ZigEmbeddedGroup/sycl-badge/carts/15/assets/joshwolfe.png

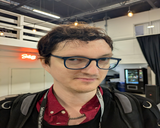
carts/15/assets/joshwolfe.png
