ZigEmbeddedGroup/sycl-badge/carts/zeroman/assets/needleman.png

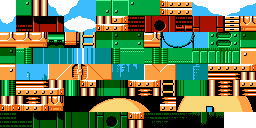
carts/zeroman/assets/needleman.png
