ZigEmbeddedGroup/sycl-badge/src/charset.png

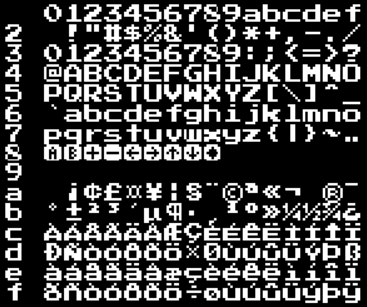
src/charset.png
