ZigEmbeddedGroup/sycl-badge/src/simulator/assets/npx_bloom_small.png

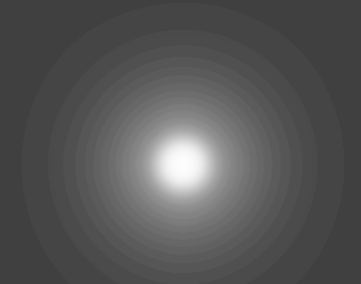
src/simulator/assets/npx_bloom_small.png
