ZigEmbeddedGroup/sycl-badge/src/simulator/assets/sim_bg.jpg

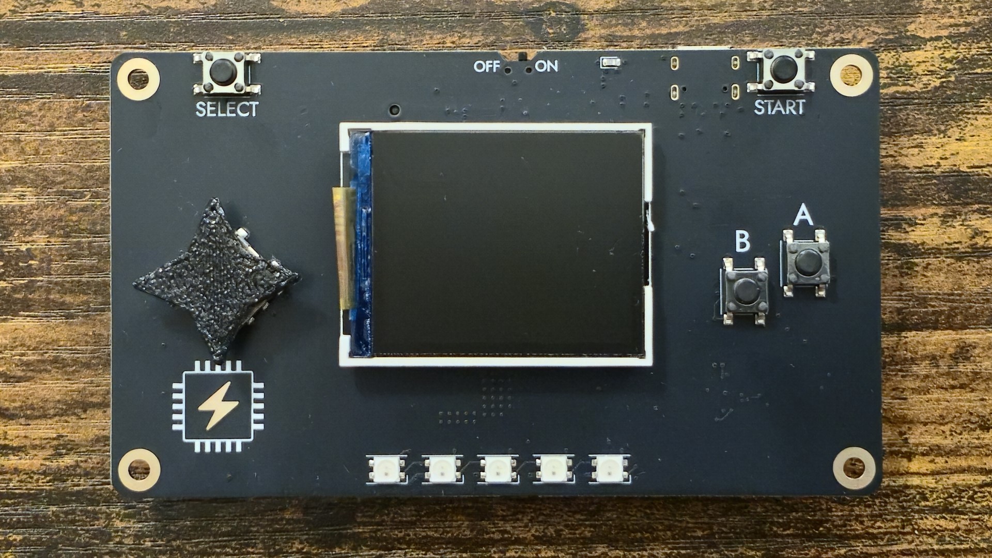
src/simulator/assets/sim_bg.jpg
