ZigEmbeddedGroup/sycl-badge/attachments/dpad_v1.3mf

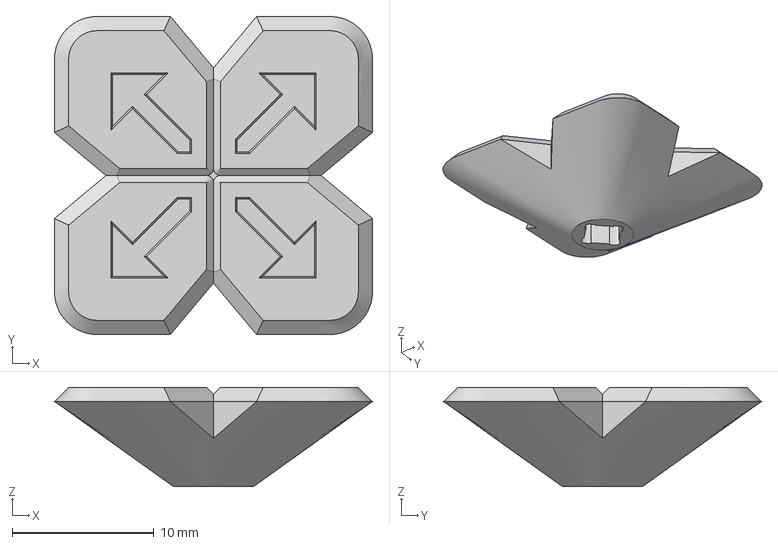
[picture p6: CAD file, 2026-08-16]
attachments/dpad_v1.3mf
22.4 x 22.4 x 7.00 mm
