ZigEmbeddedGroup/sycl-badge/kicad/v2/CMT_7525_80_SMT_TR/CMT-7525-80-SMT-TR.step

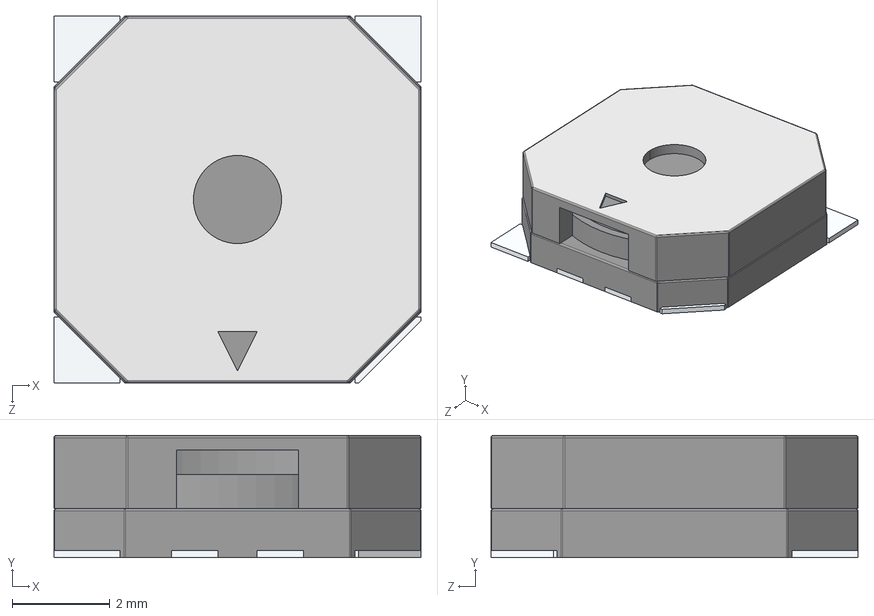
[picture p7: CAD file, 2026-04-12]
kicad/v2/CMT_7525_80_SMT_TR/CMT-7525-80-SMT-TR.step
7.50 x 2.50 x 7.50 mm
