ZigEmbeddedGroup/sycl-badge/kicad/v2/TPS61041DBVR/TPS61041DBVR.step

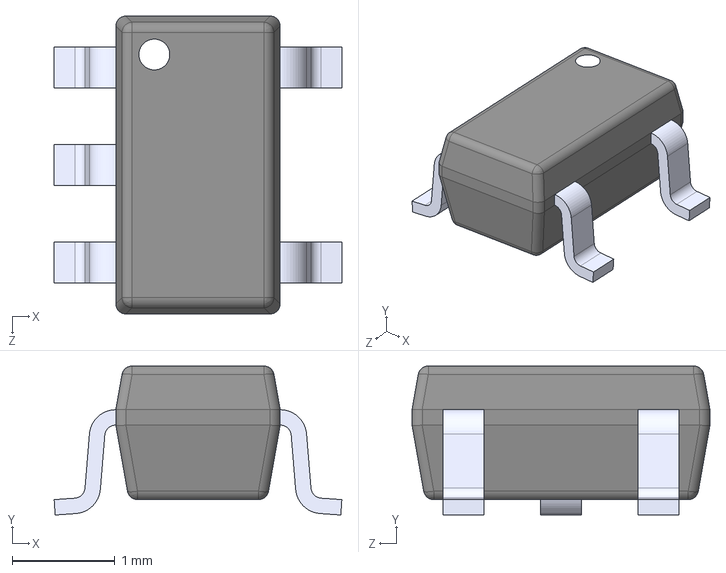
[picture p8: CAD file, 2026-04-12]
kicad/v2/TPS61041DBVR/TPS61041DBVR.step
2.80 x 1.45 x 2.90 mm
