ZigEmbeddedGroup/sycl-badge/(threads)

Thread 19 (2024-04-11):

Simulator / API Tasklist

SuperAuguste, 2024-04-11:
- [ ] `wasm4.print` that uses `std.fmt`
- [ ] custom panic handler to show panic causes to user
- [ ] Make reloader stable
- [ ] Fix `wasm4.blit`
- [ ] Explore making more `wasm4.zig` functions use structs for readability

JerwuQu, 2024-04-11:
I'll throw in a few small tasks too

- [ ] control list on game page
- [ ] SVG console border
- [ ] replace `[Z]` & `[X]` with `[A]` & `[B]` in embedded font (also for firmware)

Thread 104 (2025-10-02):

Basic File System Implementation and Storage Layer

katie-goncalves, 2025-10-02:
⦁	Look into implementing read/write to memory
⦁	File creation/deletion (subtask of the above task)
⦁	Directory structure (if needed, or flat structure) or indexing system for multiple cart storage

Thread 99 (2025-10-02):

Kernel Core

katie-goncalves, 2025-10-02:
⦁	Implement task scheduler - task switching
⦁	Implement multitasking (context switching, threads/tasks)
⦁	Memory management (stack allocation, heap basics if needed)
