ZigEmbeddedGroup/sycl-badge/(commit log)

2023-10-27 Initial vomit: Code compiles, datasheets, pinout, schematic
2023-10-28 Adds debug scripts for openocd/gdb (bad state)
    [gdb.cfg]
2023-11-24 Implement first pass display driver (#5)
2023-11-26 Implement first pass audio driver (#6)
2024-01-14 Board design Rev1 (#8)
    * rev1 of board
    * moved files
    * vendor 3d models
    [SYCL Badge 2024.kicad_pcb, SYCL Badge 2024.kicad_sch]
2024-01-15 connect B7 and A6 of USB connector (#9)
    [SYCL Badge 2024.kicad_pcb, SYCL Badge 2024.kicad_sch]
2024-01-21 implement suggestions by jacobly (#10)
    * implement suggestions by jacobly
    * remove submodule
    * make sure all tracks and vias are consistent
    [SYCL Badge 2024.kicad_pcb, SYCL Badge 2024.kicad_sch]
2024-01-22 rev1 of board (#11)
    [SYCL Badge 2024.kicad_pcb, SYCL Badge 2024.kicad_sch]
2024-01-25 rev2 of board (#12)
    * rev2 of board
    * final touches
    [SYCL Badge 2024.kicad_pcb, SYCL Badge 2024.kicad_sch]
2024-03-22 Board rev3 (#15)
    * add test points
    * switch pins on JST connector
    * rotate JST connector
    * TVS diode and testpoints
    * Revision 3 of the board
    [SYCL Badge 2024.kicad_pcb, SYCL Badge 2024.kicad_sch]
2024-04-03 Board rev A (#16)
    * drop test points, add jlcpcb production files
    [SYCL Badge 2024.kicad_pcb, SYCL Badge 2024.kicad_sch]
2024-04-23 Build watcher on macOS (#26)
    Link missing frameworks CoreFoundation and CoreServices
2024-05-14 Neopixels and light sensor work for the badge (#38)
2024-05-15 Improve accuracy of charging instructions
2024-05-15 LCD Communication fix (#48)
    * update microzig, include lcd
    * wip
    * wip
    * SPI communication with LCD is fixed
    * increase cart ram allocation
    * add framebuffer to cart fixed memory
2024-05-15 bump SPI frequency to 12MHz (#54)
2024-05-15 Implement draw functions (#53)
    * baddrawimpls
    * More drawfuncs
    * fix opt mode
    * Blit done too
    * Modify intro docs, add back feature test leds
2024-05-17 Add metal gear timer showcase (#60)
    * Add metal gear timer showcase
    * Add metalgear-timer to build.zig and build.zig.zon
2024-05-17 Merge DMA code into main (#62)
    * lcd dma
    * Implement missing functions for neopixels demo
    ---------
2024-05-18 Revert "Merge DMA code into main (#62)"
    This reverts commit 5340483f74af477412901b74645f4b9437119e59.
    This PR was not up to date.
2024-05-18 Add DVD sample (#66)
2024-05-18 Implement lcd dma (#67)
2024-05-19 Fix framebuffer writes; remove extra write (#68)
2024-05-19 Fix intro, remove samples dir (#70)
2025-08-14 Fix Missing USB Traces (#74)
    This fixes a massive issue I created for myself last year. I made the
    assumption that the matching D+/- pins on the USB-C connecter were
    electrically tied in the connector, and therefore I did not have to tie
    them together myself. This was incorrect and resulted in having to
    insert two small jumpers in every one of the 125 production boards which
    was pure pain.
    [SYCL Badge 2024.kicad_pcb]
2025-08-30 Reorganize kicad directory to allow for more boards (#76)
    [SYCL Badge 2024.kicad_pcb, SYCL Badge 2024.kicad_sch]
2025-10-16 made folder for v2 badge
    cloned files to new v2 badge folder
    [SYCL Badge 2024.kicad_pcb, SYCL Badge 2024.kicad_sch]
2025-10-16 added rp2354b symbol library
    added rp2354b symbol library + added to schematic
2025-10-17 Voltage regulator circuit
    added the voltage regulator circuit
    [HTMLparser.obj, HTMLtree.obj, SAX.obj, SAX2.obj, SYCL Badge 2024.kicad_sch, buf.obj, build_zcu.obj, c14n.obj]
2025-10-17 voltage regulator circuit
    [SYCL Badge 2024.kicad_sch]
2025-10-20 updated v2 mcu pinout
    - updated v2 mcu pinout to make connections easier
    - added decoupling capacitor circuit
    [SYCL Badge 2024.kicad_sch]
2025-10-22 added lcd conn
    [SYCL Badge 2024.kicad_sch]
2025-10-23 reverted schematic file (#110)
    reverted schematic file to git
    [SYCL Badge 2024.kicad_sch]
2025-10-24 updated MCU connections
    added various component connections to MCU
    [SYCL Badge 2024.kicad_sch]
2025-10-25 finished lcd connections
    completed lcd connection to mcu and added led driver lib
    [SYCL Badge 2024.kicad_sch]
2025-10-29 added power circuitry
    [SYCL Badge 2024.kicad_sch]
2025-10-30 fixed num of IRQ interrupt handlers 48 -> 52
2025-10-31 Updated kernel with blinking LED
2025-10-31 added usb-c
    [SYCL Badge 2024.kicad_sch]
2025-10-31 Updated build.zig to build linker kernel and boot
    *This is a working buildable code which turns the LED on*
    Build.zig: Added OS building functionality
    linker.ld: Updated to handle bootloader metadata properly
    boot.S: Added bootloader metadata section
2025-11-02 started routing pcb
    finished updating schematic and started routing v2 pcb
    [SYCL Badge 2024.kicad_pcb, SYCL Badge 2024.kicad_sch]
2025-11-05 continued routing PCB
    continued routing PCB including internal voltage regulator and USB-C portion
    [SYCL Badge 2024.kicad_pcb, SYCL Badge 2024.kicad_sch]
2025-11-05 routing pcb pt.3
    finished routing decoupling capacitors + power circuit with the switch
    [SYCL Badge 2024.kicad_pcb]
2025-11-05 Temporary build.zig with no custom linker or boot for LED blink
2025-11-06 deleted extra circuits
    deleted extra circuits - old usb-c and old mcu
    [SYCL Badge 2024.kicad_sch]
2025-11-07 continued routing PCB
    continued routing PCB - battery pack, buttons, LCD
    [SYCL Badge 2024.kicad_pcb, SYCL Badge 2024.kicad_sch]
2025-11-07 gpio and uart wrapper imports from microzig. kernel cleaned up and refactored, and rewritten in zig
2025-11-07 Updated usb driver code
2025-11-08 continued routing PCB
    continued routing PCB - USB-C, tag connect
    [SYCL Badge 2024.kicad_pcb, SYCL Badge 2024.kicad_sch]
2025-11-09 started some pours
    started doing some pours and changing width of traces
    [SYCL Badge 2024.kicad_pcb]
2025-11-10 continued drawing pours
    continued drawing pours for voltage input
    [SYCL Badge 2024.kicad_pcb]
2025-11-10 finished routing
    finished first revision routing
    [SYCL Badge 2024.kicad_pcb]
2025-11-11 DRC clean-up
    [SYCL Badge 2024.kicad_pcb]
2025-11-11 DCR complete, added testpoints on schematic
    [SYCL Badge 2024.kicad_pcb, SYCL Badge 2024.kicad_sch]
2025-11-12 testpoints added
    [SYCL Badge 2024.kicad_pcb, SYCL Badge 2024.kicad_sch]
2025-11-13 finished routing
    completed routing on pcb - ready to order first revision of v2
    [SYCL Badge 2024.kicad_pcb]
2025-11-13 exported gerber files
    exported gerber files, have to edit the bom
    [SYCL Badge 2024-B_Cu.gbl, SYCL Badge 2024-B_Mask.gbs, SYCL Badge 2024-B_Paste.gbp, SYCL Badge 2024-B_Silkscreen.gbo, SYCL Badge 2024-Edge_Cuts.gm1, SYCL Badge 2024-F_Cu.gtl, SYCL Badge 2024-F_Mask.gts, SYCL Badge 2024-F_Paste.gtp]
2025-11-13 updated uart
2025-11-13 timer changes
2025-11-13 Fixed uart.zig filed
2025-11-13 Updated timer.zig
2025-11-14 commpleted interrupt driver
2025-11-14 Increased print buffer length
2025-11-14 exported gerber files
    exported gerber files and found out ic package is wrong :(
    [SYCL Badge 2024-B_Cu.gbl, SYCL Badge 2024-B_Mask.gbs, SYCL Badge 2024-B_Paste.gbp, SYCL Badge 2024-B_Silkscreen.gbo, SYCL Badge 2024-Edge_Cuts.gm1, SYCL Badge 2024-F_Cu.gtl, SYCL Badge 2024-F_Mask.gts, SYCL Badge 2024-F_Paste.gtp]
2025-11-14 wip driveer code for lcd - untested since we have no board yet
2025-11-14 updated mcu with correct package
    updated mcu with correct packaging and finished routing and drcs
    [SYCL Badge 2024.kicad_pcb]
2025-11-15 finished updating pcb
    ready to order ! maybe..
    [SYCL Badge 2024-B_Cu.gbl, SYCL Badge 2024-B_Mask.gbs, SYCL Badge 2024-B_Paste.gbp, SYCL Badge 2024-B_Silkscreen.gbo, SYCL Badge 2024-Edge_Cuts.gm1, SYCL Badge 2024-F_Cu.gtl, SYCL Badge 2024-F_Mask.gts, SYCL Badge 2024-F_Paste.gtp]
2025-11-18 Updated documentation to have printf examples
2025-11-18 fixed references
    [SYCL Badge 2024.kicad_sch]
2025-11-22 interrupt tests
2025-11-24 Moved interrupt test to tests folder
2025-11-24 Setup init.zig for abstracted initialization and began pin assignment for lcd
2026-01-07 changes from milestone 2 doc
    [SYCL Badge 2024.kicad_pcb, SYCL Badge 2024.kicad_sch]
2026-01-07 LCD initial integration for RP Pico 2
2026-01-07 testpoints changed
    [SYCL Badge 2024.kicad_pcb, SYCL Badge 2024.kicad_sch]
2026-01-07 changed panic so it now loops for 50 while fast flashing led and attemps reboot. if it fails then stuck in while true
2026-01-08 added footprints
    added footprints for lcd connector and smd battery pack
    [SYCL Badge 2024.kicad_pcb, SYCL Badge 2024.kicad_sch]
2026-01-13 new lcd connector
    [SYCL Badge 2024.kicad_pcb, SYCL Badge 2024.kicad_sch]
2026-01-14 lcd connector
    [SYCL Badge 2024.kicad_pcb]
2026-01-14 started to change usb-c footprint
    [SYCL Badge 2024.kicad_sch]
2026-01-14 new usb-c connector
    [SYCL Badge 2024.kicad_pcb, SYCL Badge 2024.kicad_sch]
2026-01-15 finished updating usb-c connector
    [CMT-7525-80-SMT-TR.step, SYCL Badge 2024.kicad_pcb, SYCL Badge 2024.kicad_sch]
2026-01-16 finished all updates to v2 rev2
    finished drc and all updates to v2 rev2
    [SYCL Badge 2024.kicad_pcb, SYCL Badge 2024.kicad_sch]
2026-01-20 updated battery pack footprint
    [SYCL Badge 2024.kicad_pcb, SYCL Badge 2024.kicad_sch]
2026-01-20 updated lcsc part numbers
    [SYCL Badge 2024.kicad_sch]
2026-01-21 updated components with JLCPCB p/ns and downloaded Gerber files
    [SYCL Badge 2024.kicad_pcb, SYCL Badge 2024.kicad_sch]
2026-01-21 Centralized pin assignments to board_v2.zig
2026-01-28 print files on lcd
2026-02-04 Cleaned up dated comments and those intended for Pico 2 but not sycl badge
2026-02-05 Neopixel leds setup including test cart
2026-02-06 Added joystick and buttons GPIO pins
2026-02-06 Fixed led pin definition in console
2026-02-06 Fixed BL driver pin
2026-02-09 Fixed gpio bugs and setup buttons correctly
2026-02-09 Fixed panic lcd pin and added milestone 3 demo cart
2026-02-10 added u9 and fixed mcu connections
    [SYCL Badge 2024.kicad_sch, TPS61041DBVR.step]
2026-02-10 Removed all the UART code
2026-02-10 Double uart commit for no reason?
2026-02-11 added boost circuitry and changed QSPI cs
    [SYCL Badge 2024.kicad_sch]
2026-02-11 button (gpio 10)
2026-02-11 button change
2026-02-11 buttons work, just needed resistor
2026-02-12 finished schematics
    [SYCL Badge 2024.kicad_sch]
2026-02-12 stop button, added and working. cart start button doesn't work properly.. invert colors
2026-02-12 added inductor footprint
    [SYCL Badge 2024.kicad_sch]
2026-02-12 d8_ resistor added
    [SYCL Badge 2024.kicad_sch]
2026-02-12 Minor LCD fixes but still needs lots of work (DMA)
2026-02-12 updating PCB routing, LCD complete
    [SYCL Badge 2024.kicad_pcb, SYCL Badge 2024.kicad_sch]
2026-02-12 updated pcb
    [SYCL Badge 2024.kicad_pcb, SYCL Badge 2024.kicad_sch]
2026-02-14 routed booster circuit + finished bootsel
    [SYCL Badge 2024.kicad_pcb, SYCL Badge 2024.kicad_sch]
2026-02-14 added LCD testpoints
    [SYCL Badge 2024.kicad_pcb, SYCL Badge 2024.kicad_sch]
2026-02-16 implemented dma for lcd writing + fps measurements -> fixed lcd write speed
2026-02-25 carts able to be ran with buttons
2026-03-04 getting old carts working on current os setup using api + mailbox system
2026-03-06 Added tearing effect pin
2026-03-09 Kernel fixes for UI with all buttons (I hope :) )
2026-03-12 Interrupts enabled + working speaker
2026-03-16 Fixed wrong GPIO (metalgear-timer working)
2026-03-25 Added missing button documentation
2026-03-31 small scheamtic changes
    [SYCL Badge 2024.kicad_sch]
2026-04-07 made it a double frame buffer for the mailbox system + a lot of api optimization
2026-04-12 final update
    final update: finished bom, updated button silkscreen (bigger so it's more readable), added design notes.
    [SYCL Badge 2024-B_Cu.gbl, SYCL Badge 2024-B_Mask.gbs, SYCL Badge 2024-B_Paste.gbp, SYCL Badge 2024-B_Silkscreen.gbo, SYCL Badge 2024-Edge_Cuts.gm1, SYCL Badge 2024-F_Cu.gtl, SYCL Badge 2024-F_Mask.gts, SYCL Badge 2024-F_Paste.gtp]
2026-05-14 Change debug connector, convert to 0402 components.
    [SYCL Badge 2024.kicad_pcb, SYCL Badge 2024.kicad_sch]
2026-06-13 Switch wires around on debug connectors
    [SYCL Badge 2024.kicad_pcb, SYCL Badge 2024.kicad_sch]
2026-06-28 Analyze audio frequency response of the buzzer
    [CMT-7525-80-SMT-TR.csv]
2026-08-02 Implement volume control and square waves for buzzer (#118)
    * Analyze audio frequency response of the buzzer
    * Add audio test
    * Use a struct for IPC data rather than a slew of pointers
    * Add higher precision tone2 function
    * Add a timer to cart api
    * Cycle frequencies without using exp2 at runtime
    * Expand the range of playable notes by varying the PWM clock divider
    * Move audio driver to its own file
    * Switch audio wave control to software polling for debugging
    * Move buzzer wave timing to different PWM slice
    * Add volume level to audio cart
    * Add tone volume implementation to OS
    * Add global volume setting which can be updated while sounds are playing
    * Write CC values directl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
2026-08-04 V2 rev1 (#120)
    * SYCL Badge V2 PCB Revision 1
    * Move pullups
    * Finishing touches
    [SYCL Badge 2024.kicad_pcb, SYCL Badge 2024.kicad_sch]
2026-08-05 Use DMA to write the screen (#123)
2026-08-06 Stack Fixes and Audio Shapes (#126)
    * Fix stack location and crash on overflow
    * Refactor storage.zig to avoid stack overflows
    * Fix incorrect positioning logic for lcd cart buffer
    * Add sawtooth and triangle wave shapes
    * Update audio sample cart to use more features
    * fix FAT12 issues
2026-08-16 Add D-Pad 3mf model (#128)
    [dpad_v1.3mf]
2026-08-31 Revert LED default
2026-09-02 Use correct LCD startup sequence
    The current startup sequence was based off of ST7735 commands. However,
    the LCD controller is the ILI9163. I used the data from the following
    arduino library to initialize the LCD:
    https://github.com/Bodmer/TFT_eSPI/blob/master/TFT_Drivers/ILI9163_Init.h
2026-09-03 Handle device qualifier descriptor requests (#144)
    This was an unimplemented part of the new USB stack. For USB 2.0, if a
    Full Speed device does not support High Speed, it must respond to
    device qualifier requests with a failure response. This response is to
    stall the control transfer endpoint.
    This was tested on Windows, and now correctly mounts as a drive.
    In addition to this, I found a datarace in the mass storage class. It
    seemed fine, however the data race ocurrs between hardware and software.
    I was marking a buffer as ready to receive THEN copying memory from it.
    It was sometimes receiving a packet during the copy and corrupting data
    in the FAT filesystem.
2026-09-03 Fix small correctness bug in USB stack
    Even though it's working fine on windows, the spec for USB requires that
    the IN endpoint reply to the host with a STALL when it returns the error
    for the device qualifier descriptor.
    Confirmed still working on windows.
2026-09-03 Present one frame per pixel in raytracer
2026-09-04 Remove unnecessary audio DMA interrupt
2026-09-04 Avoid shutting down the mixer when switching to a different mixed tone
2026-09-04 Track audio system states
2026-09-04 Production run of the Badge
    This makes several improvements to the Badge, in time for SYCL 2026:
    - Indicator LEDs for USB and 3.3V lines.
    - Fixes GPIO alternate function mixup for the external I2C Connector.
    - Improves footprint used for solder bridges.
    - New boost converter topology for constant current backlight driver.
    The last one should fix a problem where playing audio, or plugging in
    the USB causes a noticeable change in brightness of the screen.
    Brightness is proportional to the current flowing through the LEDs. Changes
    in V+ cause small changes in the boost voltage, but as it's directly
    driving the backlight LEDs, the resulting change in current is
    perceptible.
    This makes sense f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
    [SYCL Badge 2024.kicad_pcb, SYCL Badge 2024.kicad_sch]
2026-09-04 Write stereo samples to I2S PIO
2026-09-05 Add Martin to silkscreen
    [SYCL Badge 2024.kicad_pcb]
2026-09-09 Update PCB layout and add a battery level circuit
    I've rearranged the backlight boost circuit to match the layout of the
    example layout in the datasheet. There is now a large ground plane on
    the front layer for this circuit, with a grid of vias connecting it to
    the main ground plane.
    I also added a battery voltage level circuit connected to one of the
    analog inputs. It's a voltage divider feeding into a voltage follower
    opamp circuit. There is a 100nF cap on the input to help filter out any
    noise on the battery line, whic is possible when audio is drawing a lot of
    current. It's output will be half the battery voltage, which can be as
    high as 4.5V.
    The supply for the opamp comes from V+, so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
    [SYCL Badge 2024.kicad_pcb, SYCL Badge 2024.kicad_sch]
2026-09-09 Increase DRC custom clearance to improve spacing between filled zones
    [SYCL Badge 2024.kicad_pcb, SYCL Badge 2024.kicad_sch]
2026-09-17 Add vsync and double buffer modes (#155)
    * Add vsync support (always on)
    * Add vsync and double buffer modes, and update carts to use them
    * Fix function case
2026-10-02 Add DMA channels and OS flags to ABI
2026-10-02 Light sensor with brightness auto-scaling, and battery level sensor
2026-10-02 Support lower vsync values for slower framerates
2026-10-02 Fix rev2 detection, only run battery adc on rev2+
2026-10-03 Fix the expected ADC values for detecting revision. (#168)
    The R2 badge was reading as R1. The pulldown on the ADC was not
    considered, and is now accounted for.
    [SYCL Badge 2024.kicad_sch]
2026-10-03 Rename docs to datasheets to avoid confusion
    [CMT-7525-80-SMT-TR.csv]
2026-10-04 Enable traces
2026-10-24 Remove font from board module. (#189)
